martinberlin/H-cinread-it8951/components/mini-pcb-3-to-5V-booster/mini-pcb-3-to-5V-booster.kicad_pcb

## KiCad design components/mini-pcb-3-to-5V-booster/mini-pcb-3-to-5V-booster.kicad_pcb (2022-06-08)

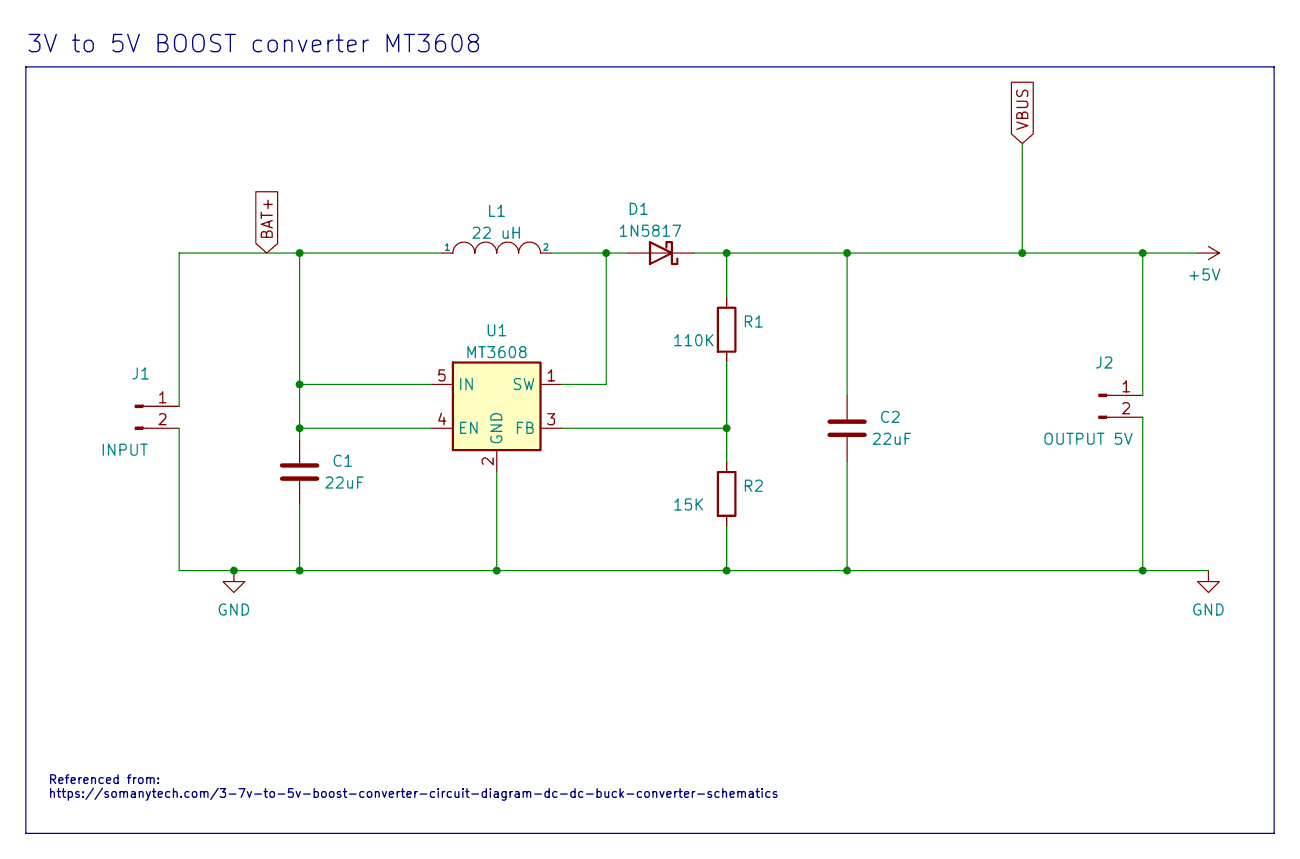
[picture p3: schematic mini-pcb-3-to-5V-booster.kicad_sch, Small PCB to test 3.7 to 5V booster converter]

Parts:
C1, C2: 22uF; C_0805_2012Metric; LCSC C1644
D1: 1N5817; D_SOD-123; LCSC C8598
J1: INPUT; PinHeader_1x02_P2.54mm_Vertical
J2: OUTPUT 5V; PinHeader_1x02_P2.54mm_Vertical
L1: 22 uH; SWPA5040S282MT; LCSC C68434
R1: 110K; R_0603_1608Metric; LCSC C25805
R2: 15K; R_0603_1608Metric; LCSC C22809
U1: MT3608; SOT-23-6; LCSC C2932326

Connections:
BAT+: C1.1, J1.1, L1.1, U1.4 (EN), U1.5 (IN)
GND: C1.2, C2.2, J1.2, J2.2, R2.2, U1.2 (GND)
unnamed: D1.2 (A), L1.2, U1.1 (SW)
unnamed: R1.2, R2.1, U1.3 (FB)
VBUS: C2.1, D1.1 (K), J2.1, R1.1

Notes on the sheet:
Referenced from: https://somanytech.com/3-7v-to-5v-boost-converter-circuit-diagram-dc-dc-buck-converter-schematics
3V to 5V BOOST converter MT3608

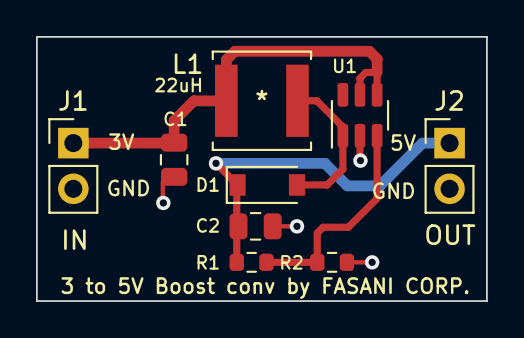
[picture p4: board mini-pcb-3-to-5V-booster.kicad_pcb from above]

Board: 2 copper layers, 25.0 x 14.7 mm, 9 parts (0 on the bottom side), 5 nets.
