martinberlin/H-cinread-it8951/(notices)

Notices in the files:
IT8951-HAT.kicad_sch:
LICENSE: CERN Open Hardware Licence Version 2
parts and their libraries:
Copyright 2021 Accelerated Designs. All rights reserved.
